kyoung-mo/pbv-cabin/supervisor/hmi/assets/modes/fullspace.png

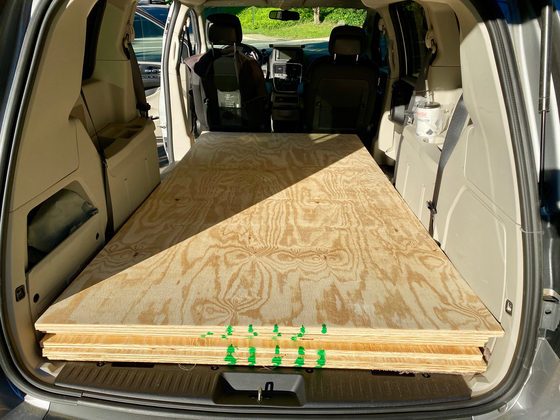
supervisor/hmi/assets/modes/fullspace.png
