kyoung-mo/pbv-cabin/supervisor/hmi/assets/modes/rest.png

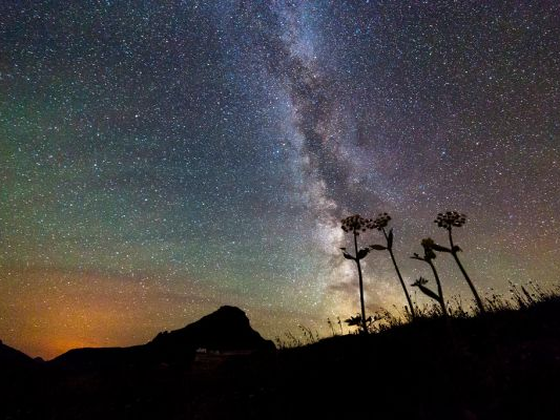
supervisor/hmi/assets/modes/rest.png
