kyoung-mo/pbv-cabin/assets/README.md

# assets — 프로젝트 정리 문서

프로젝트 서술형 산출물(정리본·요약 문서)을 두는 디렉토리.

## 내용
- **`project_summery_7.md`** — 가변 실내(Reconfigurable Cabin) **프로젝트 정리본 v7.0** (2026-07-03 기준).
  설계 원안(v6.0)을 저장소 코드와 1:1 대조해 갱신한 판으로, 각 절에 `📐 설계`(의도)와
  `🔧 구현`(코드 실측)을 병기하고, 설계-구현이 갈리는 지점을 As-Built 대조표로 모아 둔 문서.

## 주의 (문서 vs 코드)
- 이 정리본은 **2026-07-03 시점**이라, 이후 새로 구현된 것(Heartbeat 0x050 슈퍼바이저 송신,
  뒷좌석 호밍 시퀀스, 슬라이드 위치 피드백, 인터록의 슈퍼바이저 이관 등)은 반영돼 있지 않다.
- **최신·정확한 기준은 코드와 루트 [`README.md`](../README.md)** 다. 충돌 시 코드 실측을 따른다.

> 3D 모델·차체/좌석 이미지 등 HMI 런타임 에셋은 이 디렉토리가 아니라
> [`supervisor/hmi/assets/`](../supervisor/hmi/assets) 에 있다.
