kyoung-mo/pbv-cabin/supervisor/hmi/assets/car/car_00.png

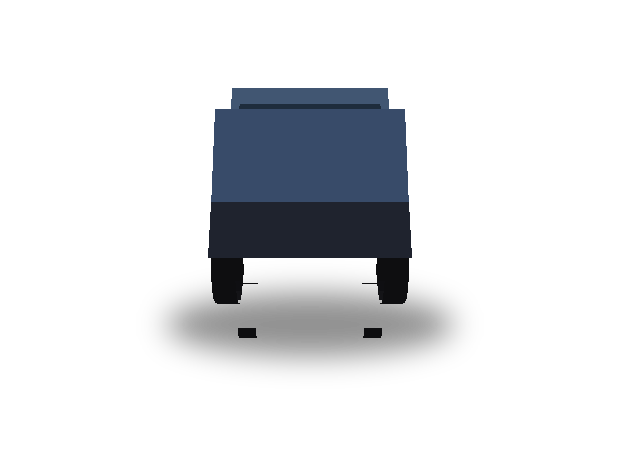
supervisor/hmi/assets/car/car_00.png
