kyoung-mo/pbv-cabin/supervisor/hmi/assets/car/car_03.png

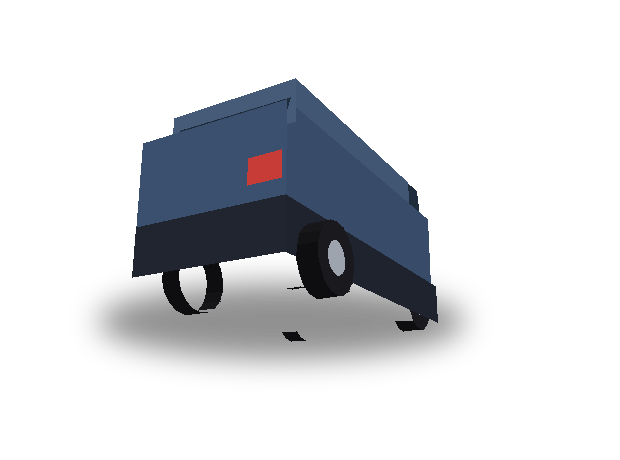
supervisor/hmi/assets/car/car_03.png
