kyoung-mo/pbv-cabin/supervisor/hmi/assets/car/car_04.png

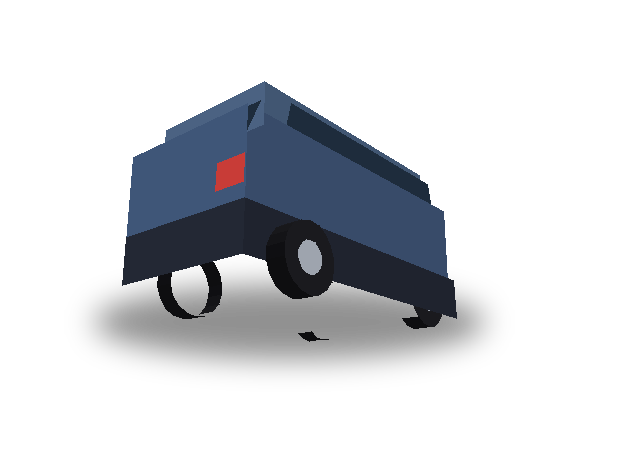
supervisor/hmi/assets/car/car_04.png
