kyoung-mo/pbv-cabin/supervisor/hmi/assets/car/car_05.png

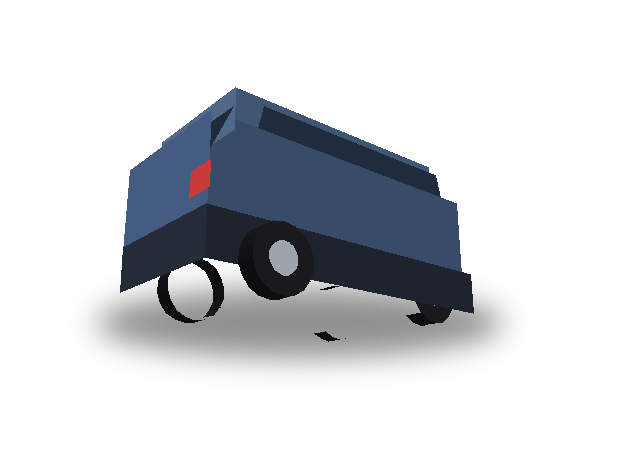
supervisor/hmi/assets/car/car_05.png
