kyoung-mo/pbv-cabin/supervisor/hmi/assets/car/car_07.png

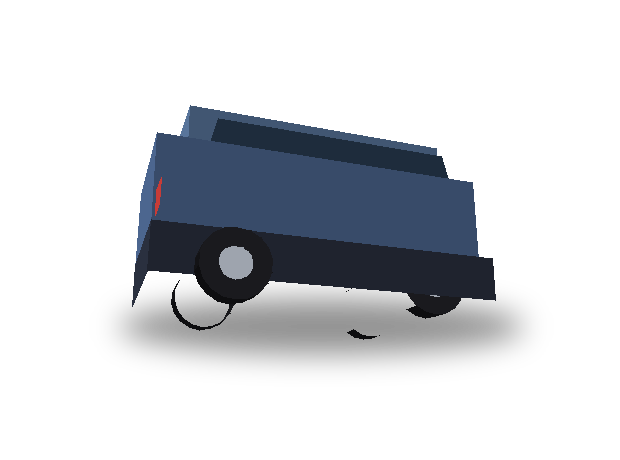
supervisor/hmi/assets/car/car_07.png
