kyoung-mo/pbv-cabin/supervisor/hmi/assets/car/car_08.png

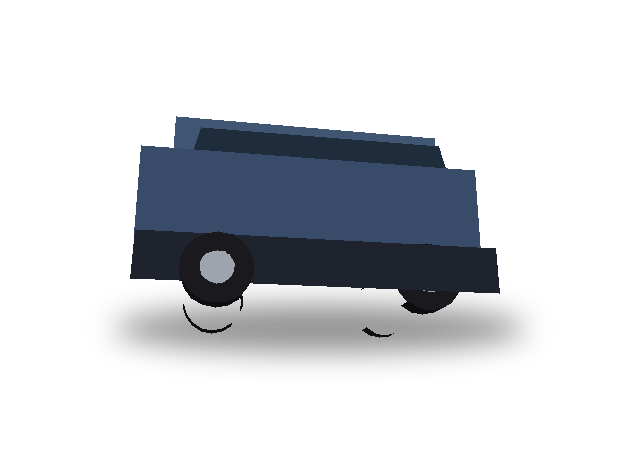
supervisor/hmi/assets/car/car_08.png
