kyoung-mo/pbv-cabin/supervisor/hmi/assets/car/car_09.png

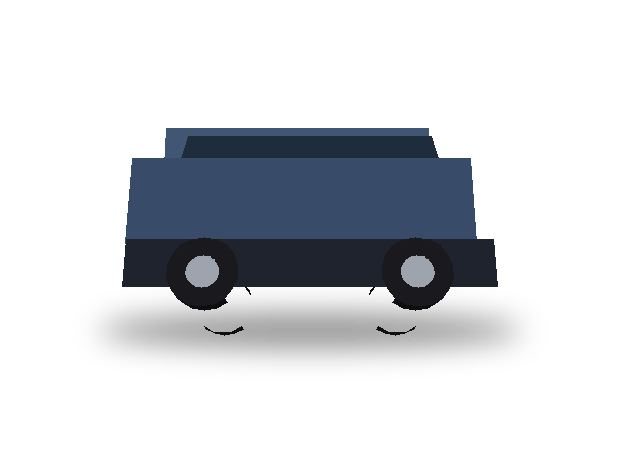
supervisor/hmi/assets/car/car_09.png
