kyoung-mo/pbv-cabin/supervisor/hmi/assets/car/car_12.png

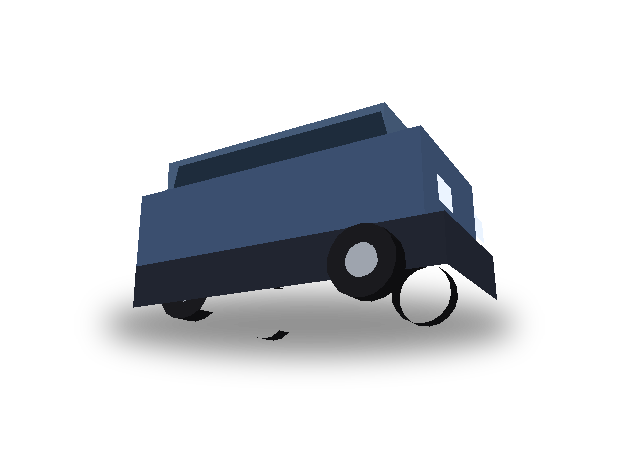
supervisor/hmi/assets/car/car_12.png
