kyoung-mo/pbv-cabin/supervisor/hmi/assets/car/car_14.png

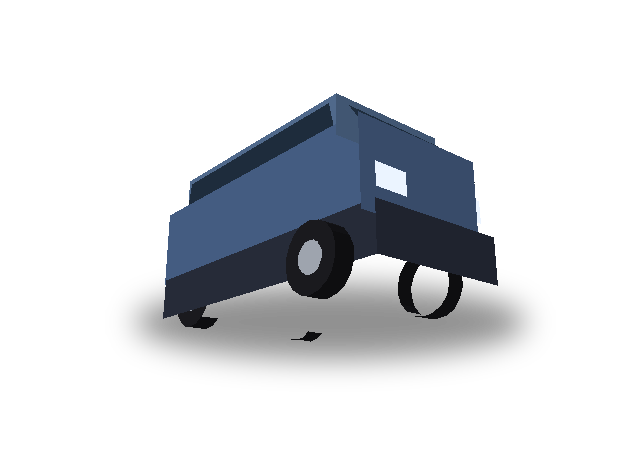
supervisor/hmi/assets/car/car_14.png
