kyoung-mo/pbv-cabin/supervisor/hmi/assets/car/car_15.png

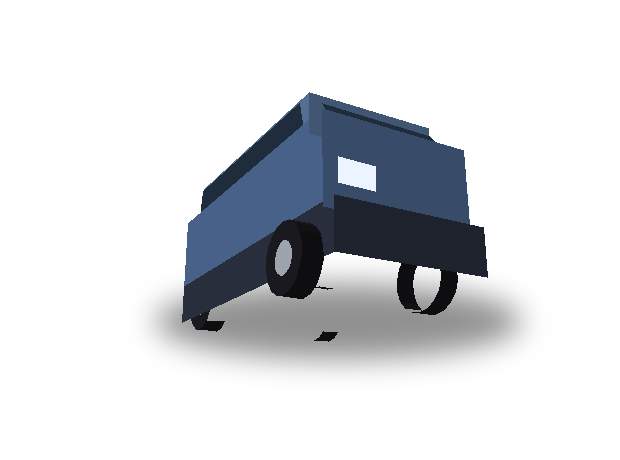
supervisor/hmi/assets/car/car_15.png
