kyoung-mo/pbv-cabin/supervisor/hmi/assets/car/car_16.png

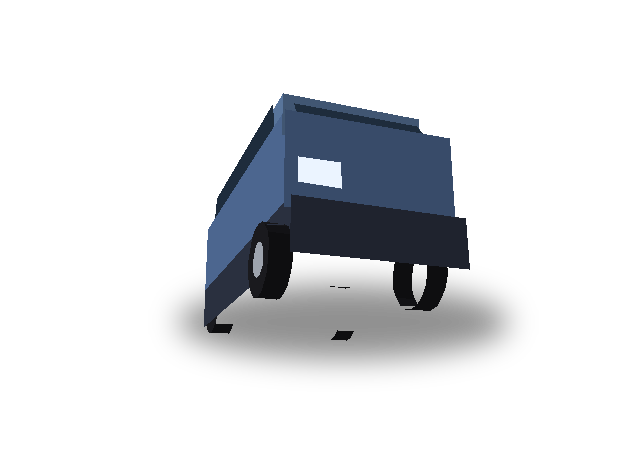
supervisor/hmi/assets/car/car_16.png
