kyoung-mo/pbv-cabin/supervisor/hmi/assets/car/car_26.png

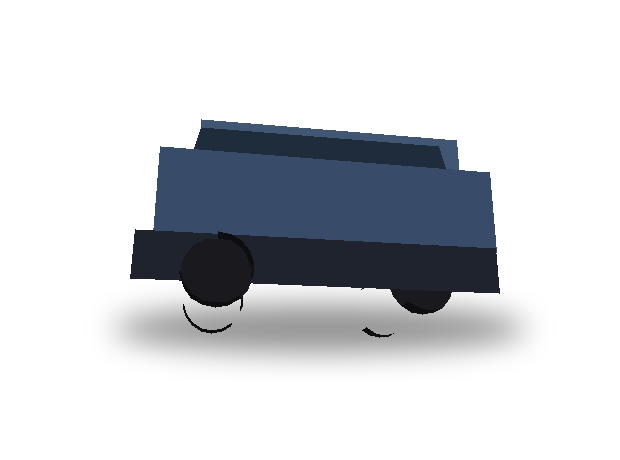
supervisor/hmi/assets/car/car_26.png
