kyoung-mo/pbv-cabin/supervisor/hmi/assets/car/car_27.png

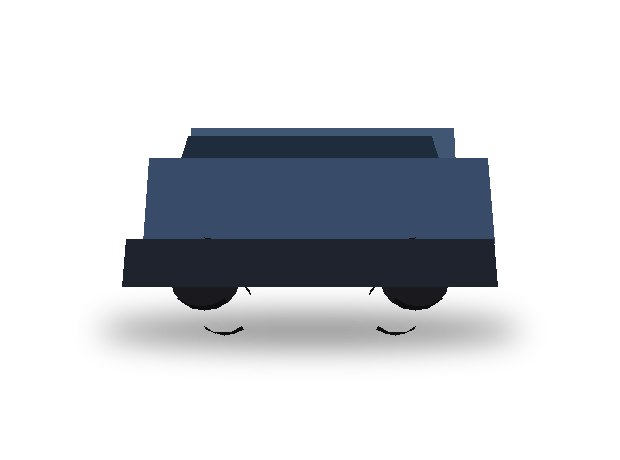
supervisor/hmi/assets/car/car_27.png
