kyoung-mo/pbv-cabin/supervisor/hmi/assets/car/car_29.png

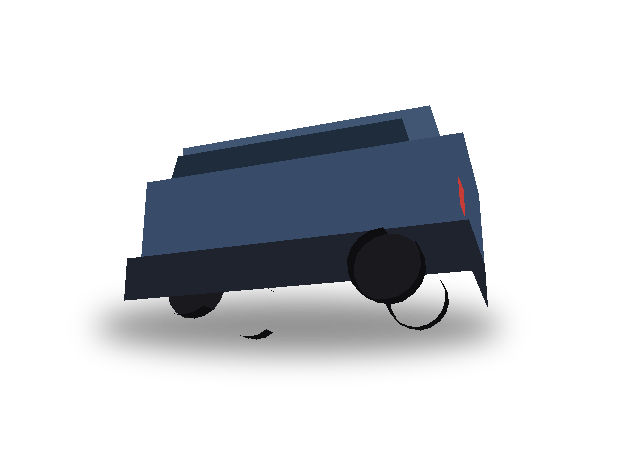
supervisor/hmi/assets/car/car_29.png
