kyoung-mo/pbv-cabin/supervisor/hmi/assets/car/car_30.png

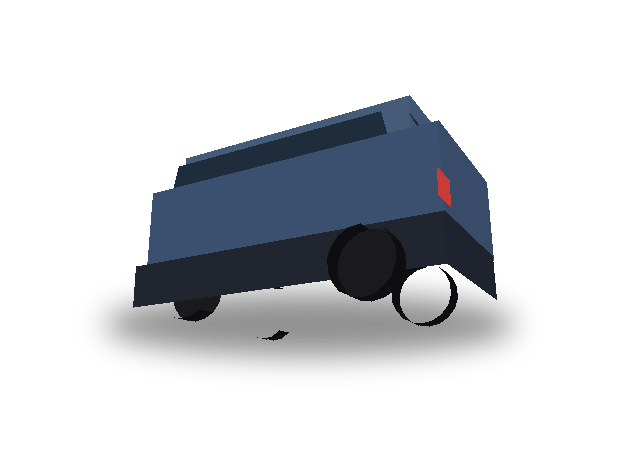
supervisor/hmi/assets/car/car_30.png
