kyoung-mo/pbv-cabin/supervisor/hmi/assets/car/car_32.png

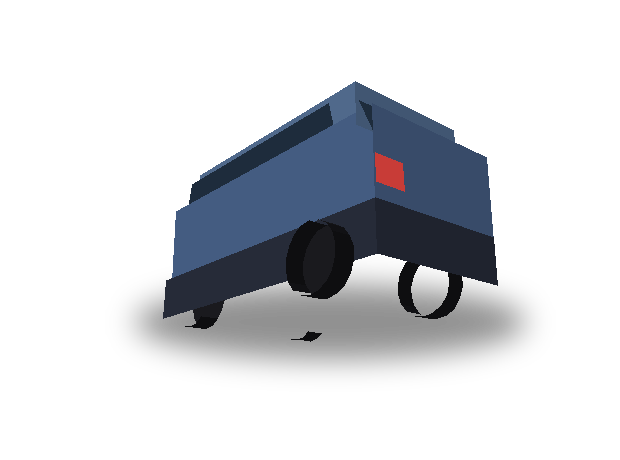
supervisor/hmi/assets/car/car_32.png
