kyoung-mo/pbv-cabin/supervisor/hmi/assets/modes/drive.png

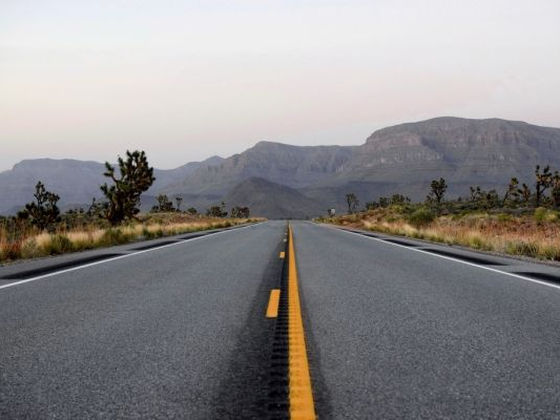
supervisor/hmi/assets/modes/drive.png
