kyoung-mo/pbv-cabin/supervisor/hmi/assets/modes/meeting.png

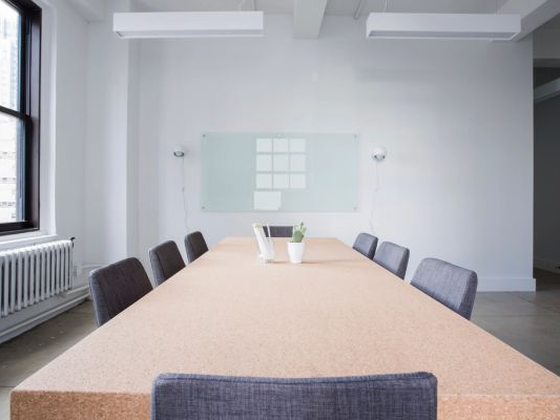
supervisor/hmi/assets/modes/meeting.png
