kyoung-mo/pbv-cabin/supervisor/hmi/assets/seats/overview.png

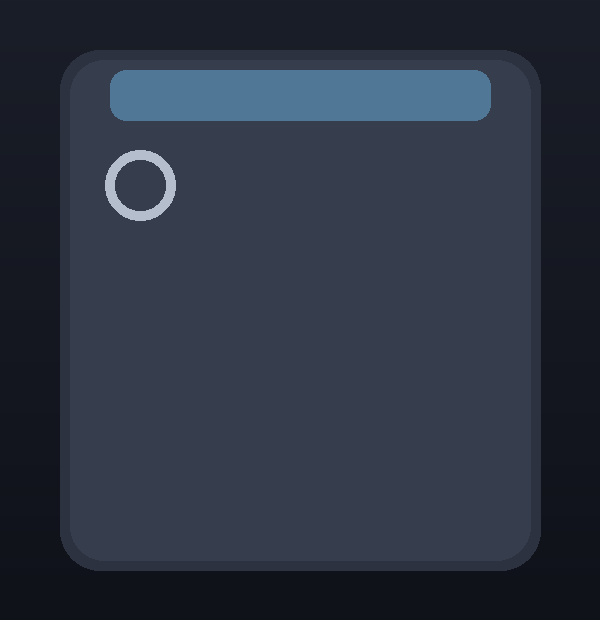
supervisor/hmi/assets/seats/overview.png
