kyoung-mo/pbv-cabin/supervisor/hmi/assets/seats/seat.png

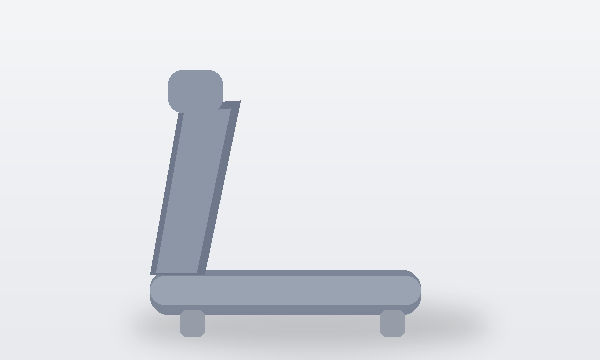
supervisor/hmi/assets/seats/seat.png
