kyoung-mo/pbv-cabin/ecu-drive/PowerTrain_F446/Core/Src/main.c

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
/* Includes ------------------------------------------------------------------*/
#include "main.h"

/* USER CODE BEGIN Includes */
#include "model_car_net.h"
/* USER CODE END Includes */

CAN_HandleTypeDef hcan1;

TIM_HandleTypeDef htim1;
TIM_HandleTypeDef htim2;
TIM_HandleTypeDef htim3;

UART_HandleTypeDef huart2;

/* USER CODE BEGIN PV */
/* CAN 통신용 구조체 변수 */
struct model_car_net_drive_cmd_t rx_drive_cmd;       // 수신된 주행 명령 저장용
struct model_car_net_drive_status_t tx_drive_status; // 송신할 구동 상태 저장용
struct model_car_net_heartbeat_t rx_heartbeat;       // 수신된 하트비트 저장용
struct model_car_net_gear_status_t rx_gear_status;   // 0x070 기어 상태 추가
struct model_car_net_safe_abort_t rx_safe_abort;     // 0x010 세이프 어보트 확장

/* CAN 송수신 하드웨어 핸들러 및 헤더 */
CAN_RxHeaderTypeDef rx_header;
CAN_TxHeaderTypeDef tx_header;
uint8_t rx_data[8];
uint8_t tx_data[8];
uint32_t tx_mailbox;

/* 하드웨어 테스트용 CAN 송신 변수 */
CAN_TxHeaderTypeDef test_tx_header;
uint8_t test_tx_data[8];
uint32_t test_mailbox;

/* 세이프티 및 페일세이프 관련 변수 */
volatile uint32_t cmd_watchdog_timer = 0; // 인터럽트 공유를 위해 전역으로 이동 및 volatile 적용
uint32_t supervisor_wd_timer = 0; // 하트비트 무응답 시간 누적용 (ms 단위 카운트)
uint8_t last_alive_counter = 0;   // 이전 하트비트 카운트 값 백업
bool is_emergency_active = false; // 현재 비상 정지 상태 여부 플래그
uint8_t current_gear = 0;         // 0=P, 1=D, 2=R 로컬 백업용

/* 엔코더 측정 및 속도 계산 변수 */
int16_t left_encoder_count = 0;
int16_t right_encoder_count = 0;
double current_rpm = 0.0;

/* 이전 듀티 저장용 전역 변수 */
uint32_t prev_left_duty = 0;
uint32_t prev_right_duty = 0;
/* USER CODE END PV */

void SystemClock_Config(void);
static void MX_GPIO_Init(void);
static void MX_USART2_UART_Init(void);
static void MX_CAN1_Init(void);
static void MX_TIM1_Init(void);
static void MX_TIM2_Init(void);
static void MX_TIM3_Init(void);
/* USER CODE BEGIN PFP */
double calculate_actual_rpm(int16_t left_counts, int16_t right_counts);
/* USER CODE END PFP */

/**
  * @brief  The application entry point.
  * @retval int
  */
int main(void)
{

  /* MCU Configuration--------------------------------------------------------*/

  /* Reset of all peripherals, Initializes the Flash interface and the Systick. */
  HAL_Init();

  /* Configure the system clock */
  SystemClock_Config();

  /* Initialize all configured peripherals */
  MX_GPIO_Init();
  MX_USART2_UART_Init();
  MX_CAN1_Init();
  MX_TIM1_Init();
  MX_TIM2_Init();
  MX_TIM3_Init();
  /* USER CODE BEGIN 2 */
  /* ====================================================================
 * 1. CAN 하드웨어 활성화 및 필터 마스터 세팅 (PCAN-View 통신 개통용)
 * ==================================================================== */


// 모든 CAN ID를 필터링 없이 다 받아들이는 '마스터 오픈 필터' 설정
CAN_FilterTypeDef canFilter;
canFilter.FilterBank = 0;
canFilter.FilterMode = CAN_FILTERMODE_IDMASK;
canFilter.FilterScale = CAN_FILTERSCALE_32BIT;
canFilter.FilterIdHigh = 0x0000;
canFilter.FilterIdLow = 0x0000;
canFilter.FilterMaskIdHigh = 0x0000;
canFilter.FilterMaskIdLow = 0x0000;
canFilter.FilterFIFOAssignment = CAN_RX_FIFO0;
canFilter.FilterActivation = ENABLE;
canFilter.SlaveStartFilterBank = 14;

if (HAL_CAN_ConfigFilter(&hcan1, &canFilter) != HAL_OK) {
	Error_Handler(); // 필터 설정 실패 시 잠금
}

// CAN 외장 하드웨어 선로 전격 개통! (이게 켜져야 PCAN Receive가 뚫립니다)
if (HAL_CAN_Start(&hcan1) != HAL_OK) {
	Error_Handler();
}

// CAN 수신 인터럽트(FIFO0 Pending) 활성화
if (HAL_CAN_ActivateNotification(&hcan1, CAN_IT_RX_FIFO0_MSG_PENDING) != HAL_OK) {
	Error_Handler();
}

// 송신 헤더 설정
//tx_header.StdId = 0x102; // F446용 테스트 ID
//tx_header.RTR = CAN_RTR_DATA;
//tx_header.IDE = CAN_ID_STD;
//tx_header.DLC = 8;
//tx_header.TransmitGlobalTime = DISABLE;

/* ====================================================================
 * 2. 타이머 하드웨어 기동 (좌/우 모터 및 엔코더 작동 시작)
 * ==================================================================== */
// (1) TIM1 PWM 출력 채널 가동 (모터 속도 제어선 활성화)
HAL_TIM_PWM_Start(&htim1, TIM_CHANNEL_1); // PA8 (PWMA)
HAL_TIM_PWM_Start(&htim1, TIM_CHANNEL_2); // PA9 (PWMB)

// (2) TIM2, TIM3 엔코더 카운터 하드웨어 감시 기동
HAL_TIM_Encoder_Start(&htim2, TIM_CHANNEL_ALL); // 왼쪽 바퀴 엔코더 감시 시작
HAL_TIM_Encoder_Start(&htim3, TIM_CHANNEL_ALL); // 오른쪽 바퀴 엔코더 감시 시작
  /* USER CODE END 2 */

  /* Infinite loop */
  /* USER CODE BEGIN WHILE */
  while (1)
  {
    /* USER CODE END WHILE */

    /* USER CODE BEGIN 3 */
	HAL_Delay(10);
	if (cmd_watchdog_timer < 1000) {
		cmd_watchdog_timer += 10;
	}

	// 2. [엔코더 데이터 수집] 좌/우 타이머 카운터 레지스터에서 펄스 값 실시간 획득
	left_encoder_count  = (int16_t)__HAL_TIM_GET_COUNTER(&htim2);
	right_encoder_count = (int16_t)__HAL_TIM_GET_COUNTER(&htim3);
	__HAL_TIM_SET_COUNTER(&htim2, 0);
	__HAL_TIM_SET_COUNTER(&htim3, 0);

	// 실시간 실제 RPM 산출
	current_rpm = calculate_actual_rpm(left_encoder_count, right_encoder_count);

	// [최우선순위 안전 제어] 비상정지 락이 걸렸거나, 300ms 동안 주행명령(0x100)이 끊겼다면 (Timeout)?
	if (is_emergency_active || cmd_watchdog_timer > 300)
	{
		// 모터 즉각 정지 및 Short Brake 잠금 발동
		HAL_GPIO_WritePin(GPIOB, GPIO_PIN_5, GPIO_PIN_SET);   // IN1
		HAL_GPIO_WritePin(GPIOB, GPIO_PIN_4, GPIO_PIN_SET);   // IN2
		HAL_GPIO_WritePin(GPIOB, GPIO_PIN_10, GPIO_PIN_SET);  // IN3
		HAL_GPIO_WritePin(GPIOA, GPIO_PIN_10, GPIO_PIN_SET);  // IN4
		__HAL_TIM_SET_COMPARE(&htim1, TIM_CHANNEL_1, 0);
		__HAL_TIM_SET_COMPARE(&htim1, TIM_CHANNEL_2, 0);

		// ★ [Fail-Safe 가드 레일 보완] 비상 정지 복귀 시 Ramp 튐 현상을 막기 위해 백업 데이터 리셋
		prev_left_duty = 0;
		prev_right_duty = 0;

		// 피드백 데이터 빌드: 속도는 0, 현재 기어 상태 및 에러 플래그 결합 송신
		tx_drive_status.current_velocity = 0;
		tx_drive_status.current_gear_status = current_gear;
		tx_drive_status.drive_motor_current = 0;

		// 0x102 Drive_Status CAN 송신 함수 호출 (10ms 주기 세이프티 송신)
		model_car_net_drive_status_pack(tx_data, &tx_drive_status, sizeof(tx_data));

		tx_header.StdId = MODEL_CAR_NET_DRIVE_STATUS_FRAME_ID; // 0x200
		tx_header.RTR = CAN_RTR_DATA;
		tx_header.IDE = CAN_ID_STD;
		tx_header.DLC = MODEL_CAR_NET_DRIVE_STATUS_LENGTH;     // 8u
		HAL_CAN_AddTxMessage(&hcan1, &tx_header, tx_data, &tx_mailbox);

		continue; // 아래 주행 로직을 스킵하고 루프 처음으로 점프
	}

	// 4. [일반 주행 제어] 기어 상태 인터록 및 상하위 속도 연산
	double brake_factor = (100.0 - (double)rx_drive_cmd.brake_depth) / 100.0;
	double v_base = (double)rx_drive_cmd.target_velocity * brake_factor;

	double K = 0.5; // 필요시 민감도를 2.5 등으로 올려서 테스트하세요!
	double v_steer = (double)rx_drive_cmd.steering_angle * K;

	double target_left_rpm  = v_base + v_steer;
	double target_right_rpm = v_base - v_steer;

	if (rx_drive_cmd.brake_depth >= 100) {
		target_left_rpm = 0; target_right_rpm = 0;
	}

	if (target_left_rpm < 0)  target_left_rpm = 0;
	if (target_right_rpm < 0) target_right_rpm = 0;

	uint32_t left_duty  = ((uint32_t)target_left_rpm * 999) / 3000;
	uint32_t right_duty = ((uint32_t)target_right_rpm * 999) / 3000;

	if (left_duty > 999)  left_duty = 999;
	if (right_duty > 999) right_duty = 999;

	#define MAX_DUTY_STEP 15
	// 왼쪽 바퀴 Ramp 적용
	if (left_duty > prev_left_duty) {
		if ((left_duty - prev_left_duty) > MAX_DUTY_STEP) left_duty = prev_left_duty + MAX_DUTY_STEP;
	} else if (left_duty < prev_left_duty) {
		if ((prev_left_duty - left_duty) > MAX_DUTY_STEP) left_duty = prev_left_duty - MAX_DUTY_STEP;
	}

	// 오른쪽 바퀴 Ramp 적용
	if (right_duty > prev_right_duty) {
		if ((right_duty - prev_right_duty) > MAX_DUTY_STEP) right_duty = prev_right_duty + MAX_DUTY_STEP;
	} else if (right_duty < prev_right_duty) {
		if ((prev_right_duty - right_duty) > MAX_DUTY_STEP) right_duty = prev_right_duty - MAX_DUTY_STEP;
	}

	// 다음 루프를 위해 현재 값 백업
	prev_left_duty = left_duty;
	prev_right_duty = right_duty;

	// [일반 주행 제어] 기어 상태 인터록 검증
	if (current_gear == 1) // 1 = Drive(D)
	{
		HAL_GPIO_WritePin(GPIOB, GPIO_PIN_5, GPIO_PIN_SET);   // AIN1 = HIGH
		HAL_GPIO_WritePin(GPIOB, GPIO_PIN_4, GPIO_PIN_RESET); // AIN2 = LOW
		HAL_GPIO_WritePin(GPIOB, GPIO_PIN_10, GPIO_PIN_SET);  // BIN1 = HIGH
		HAL_GPIO_WritePin(GPIOA, GPIO_PIN_10, GPIO_PIN_RESET); // BIN2 = LOW

		__HAL_TIM_SET_COMPARE(&htim1, TIM_CHANNEL_1, left_duty);
		__HAL_TIM_SET_COMPARE(&htim1, TIM_CHANNEL_2, right_duty);
	}
	else if (current_gear == 2) // 2 = Reverse
	{
		HAL_GPIO_WritePin(GPIOB, GPIO_PIN_5, GPIO_PIN_RESET);   // AIN1 = LOW
		HAL_GPIO_WritePin(GPIOB, GPIO_PIN_4, GPIO_PIN_SET);     // AIN2 = HIGH
		HAL_GPIO_WritePin(GPIOB, GPIO_PIN_10, GPIO_PIN_RESET);  // BIN1 = LOW
		HAL_GPIO_WritePin(GPIOA, GPIO_PIN_10, GPIO_PIN_SET);    // BIN2 = HIGH

		__HAL_TIM_SET_COMPARE(&htim1, TIM_CHANNEL_1, left_duty);
		__HAL_TIM_SET_COMPARE(&htim1, TIM_CHANNEL_2, right_duty);
	}
	else // P(0) 모드이거나 예외 상태 시 안전 정지
	{
		HAL_GPIO_WritePin(GPIOB, GPIO_PIN_5, GPIO_PIN_SET);
		HAL_GPIO_WritePin(GPIOB, GPIO_PIN_4, GPIO_PIN_SET);
		HAL_GPIO_WritePin(GPIOB, GPIO_PIN_10, GPIO_PIN_SET);
		HAL_GPIO_WritePin(GPIOA, GPIO_PIN_10, GPIO_PIN_SET);

		__HAL_TIM_SET_COMPARE(&htim1, TIM_CHANNEL_1, 0);
		__HAL_TIM_SET_COMPARE(&htim1, TIM_CHANNEL_2, 0);
	}
	// 5. [상태 피드백 역송신] 0x102 Drive_Status 주기 송신 처리
	// 인코드 함수 규격에 맞춰 정수형 변환 처리 (ex: 0.1 스케일 팩터가 있다면 10배 곱해짐)
	tx_drive_status.current_velocity = (int16_t)(current_rpm);
	tx_drive_status.current_gear_status = current_gear;

	// 라이브러리 패킹 후 CAN Mailbox로 데이터 밀어내기
	model_car_net_drive_status_pack(tx_data, &tx_drive_status, sizeof(tx_data));

	tx_header.StdId = MODEL_CAR_NET_DRIVE_STATUS_FRAME_ID; // 0x200
	tx_header.RTR = CAN_RTR_DATA;
	tx_header.IDE = CAN_ID_STD;
	tx_header.DLC = MODEL_CAR_NET_DRIVE_STATUS_LENGTH;     // 8u
	HAL_CAN_AddTxMessage(&hcan1, &tx_header, tx_data, &tx_mailbox);
  }
  /* USER CODE END 3 */
}

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
/* USER CODE BEGIN 4 */
double calculate_actual_rpm(int16_t left_counts, int16_t right_counts)
{
    // 두 바퀴의 평균 펄스 변화량
    double avg_counts = (double)(left_counts + right_counts) / 2.0;

    /* [RPM 계산 가이드라인]
     * JBG37-520 모터의 감속비가 예를 들어 1:30이고 홀센서가 한 바퀴에 11펄스를 뿜는다면,
     * 4체배 시 바퀴 1회전당 총 펄스(PPR) = 11 * 4 * 30 = 1320 펄스입니다.
     * 10ms(0.01초) 주기로 셈하므로: RPM = (avg_counts / 1320) * (60초 / 0.01초)
     */
    double ppr = 1320.0; // 팀의 모터 상세 스펙에 맞춰 수정 가능
    double actual_rpm = (avg_counts / ppr) * 6000.0;

    return actual_rpm;
}

void HAL_CAN_RxFifo0MsgPendingCallback(CAN_HandleTypeDef *hcan)
{

	if (HAL_CAN_GetRxMessage(hcan, CAN_RX_FIFO0, &rx_header, rx_data) != HAL_OK) return;

	HAL_GPIO_TogglePin(LD2_GPIO_Port, LD2_Pin); // 정상 수신 알림 점멸

	// 1. 비상 정지 수신
	if (rx_header.StdId == MODEL_CAR_NET_SAFE_ABORT_FRAME_ID) {
		model_car_net_safe_abort_unpack(&rx_safe_abort, rx_data, rx_header.DLC);
		if (rx_safe_abort.stop_flag == 1) {
			is_emergency_active = true;
		} else if (rx_safe_abort.stop_flag == 0) {
			// (3)번 문제 해결: stop_flag가 명시적으로 0이 들어오면 비상 정지 해제!
			is_emergency_active = false;
		}
	}
	// 2. 기어 상태 수신
	else if (rx_header.StdId == MODEL_CAR_NET_GEAR_STATUS_FRAME_ID) {
		model_car_net_gear_status_unpack(&rx_gear_status, rx_data, rx_header.DLC);
		current_gear = rx_gear_status.gear;
	}
	// 3. 주행 명령 수신
	else if (rx_header.StdId == MODEL_CAR_NET_DRIVE_CMD_FRAME_ID) {
		model_car_net_drive_cmd_unpack(&rx_drive_cmd, rx_data, rx_header.DLC);
		cmd_watchdog_timer = 0; // (1),(2)번 문제 해결을 위한 통신 와치독 타이머 리셋!
	}
}
/* USER CODE END 4 */
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
