kyoung-mo/pbv-cabin/(commit log)

2026-06-22 can 메시지별 신호 잡기
2026-06-22 can dbc 수정, main.c skeleton complete
2026-06-23 modified ioc, motor control logic added to main.c
2026-06-23 fix main.c for modified DBC
    [PowerTrain_F446.ioc, main.c]
2026-06-25 can 통신을 통한 모터 제어 성공. 예외처리 및 상세화 필요
2026-06-29 기능 테스트 완료. 회로 안전 로직 필요
2026-06-30 로직 수정한 버전. 실물 테스트 아직 못함
    [main.c]
2026-06-30 ecu-rear-cargo: 펌웨어 slide3(TMC2208 2축) 추가, 기존본 slide2로 이동
    - firmware/slide3: TMC2208 STEP/DIR/EN 2축(RL/RR) + SG90 서보 x2 + INA226 안티핀치 + model_car_net(DBC). DWT us 타이밍, 가속램프, 1/2 마이크로스텝.
    - firmware/slide2: 기존 스켈레톤 보존용 이동.
2026-06-30 supervisor/hmi: CAN 양방향 연동 + 휠 입력 통합 + 체크섬 ECU 정합(8bit 합)
2026-07-01 freeRTOS 버전 추가 / 테스트 X
2026-07-01 add can message && racing wheel(?) data
2026-07-01 기능 정상 동작 확인 조향각에 따른 앞바퀴 회전은 미반영
2026-07-01 조향각에 따른 바퀴 회전 추가
2026-07-01 D/R 모드에 따라 엑셀 -> 바퀴 회전 추가
2026-07-01 조향각에 따른 시각적 표시 추가
2026-07-01 조향 핸들 색상 변경
2026-07-02 HDMI 작동 테스트 완료
2026-07-02 HMI 화면 수정. 기어 P인 상태에서도 조향각, 엑셀, 브레이크 읽을 수 있도록
    [vehicle_state.py, wheel_input.py]
2026-07-02 ecu-rear-cargo: slide4 FreeRTOS 포팅 추가 (MotionTask/StatusTask, RL/RR 2축 동작)
2026-07-02 UI 개선(하단바 크기 조절 + 홈 모드에서 자동차 보이는 모습)
2026-07-03 좌석 과전류 긴급정지(E-stop) 상태 표시 추가
    3D 좌석에 과전류 긴급정지 시 빨강~핑크 깜빡임 경고. vehicle_state에
    seatEstop 프로퍼티/estopChanged 시그널/setSeatEstop 슬롯 추가(CAN 수신 훅).
2026-07-03 docs: 프로젝트 정리본 v7.0 추가 + 낡은 interface DBC 삭제
    assets/project_summery_7.md 신규(코드 실측 대조본). CAN 정본을
    supervisor/dbc로 확정하고, 초기 업로드본 interface/dbc/model_car_net.dbc 제거.
2026-07-05 rear-cargo: 슬라이드 2축 인터록 추가 (동시구동 차단)
    - slide_service에 s_active 인터록: 한 번에 한 축만 스텝(RL 우선),
    대기축 드라이버 OFF → 동시 구동의 과전류·회생 스파이크로 인한
    드라이버 손상 방지
    - slide_is_moving / slide_ch_is_moving / slide_ch_pending API 추가
    - 런타임/부팅 호밍 모두 단일축 보장
    - model_car_net.dbc 포함
2026-07-05 rear-slide: 원점 정렬(호밍) 확인-스텝 시퀀스 + 부팅 자동 호밍
    - vehicle_state: 뒷좌석 슬라이드 호밍 시퀀스(왼쪽→확인→오른쪽→확인→주행자세
    복귀), 직렬화 인터록(두 리니어 동시 구동 금지), homingActive/Prompt Property.
    - can_hub: send_seat_cmd slide_raw 인자 추가 — 254(HOME)/255(REZERO) 센티넬을
    DBC 무변경으로 byte1 직접 덮어써 송신.
    - main: 부팅 1.2s 뒤 자동 원점 정렬 시작(slide4 SLIDE_HOMING=0 보완).
    - Main.qml/SeatOverview.qml: 호밍 오버레이(화면 잠금+확인 버튼) + 수동 원점
    버튼, 끼임 배지.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
2026-07-05 rear-cargo: 슬라이드 현재위치 CAN 상태 피드백 추가 (0x220/0x221 byte2)
    - DBC/생성코드: Rear_*_Seat_Status DLC 2→3, Curr_RL/RR_Slide(0~100mm) 추가
    (팀 재생성본 채용, cantools 41.4.3)
    - slide.c/h: homed 플래그 + slide_report_pos_mm()
    · 원점 미확정(부팅/호밍 중)엔 0xFF 센티넬 → 중앙이 "호밍 필요"로 인식
    · 254 호밍 완료 / 255 재영점에서 homed=1 → 실제 0~100 보고
    - main.c send_status: byte2 = slide_report_pos_mm(ch)
    - main.c: 비상 핸들러를 SafeAbort로 정정(옛 HMI_Emergency 참조가
    stale 생성코드에 의존하던 잠재 불일치 → 재생성으로 표면화된 것 수정)
    - STM32CubeCLT 빌드 통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
    [main.c]
2026-07-05 supervisor: 끼임(과전류) 감지 오버레이 + 확인 시 재명령 래치 해제
    - vehicle_state: pinchPrompt(안내문) / resolvePinch(끼인 좌석 재명령→펌웨어 래치 해제)
    - Main.qml: 오른쪽 패널 위 경고 오버레이 + [확인] 버튼
    ※ 실물 검증은 뒷자리 펌웨어 완성본과 통합 후 확인 예정.
    [vehicle_state.py]
2026-07-05 supervisor/dbc: 뒷좌석 슬라이드 위치 피드백 반영 (firmware 완성본 동기화)
    Rear_Left/Right_Seat_Status DLC 2->3, byte2에 Curr_RL/RR_Slide(16|8, [0|100]mm) 추가.
    ecu-rear-cargo 정본 DBC와 동일 정의. HMI 디코드 규약: slide==255 원점미확정 / 0~100 실측mm.
2026-07-05 supervisor: 뒷좌석 슬라이드 위치 피드백 수신(closed-loop 스냅)
    리어 ECU가 Rear_Left/Right_Seat_Status byte2(Curr_*_Slide)로 슬라이드 위치를 보고
    (0~100mm, 255=원점 미확정). 이동 중엔 StatusTask 기아로 상태가 끊기고 완료 시 재개되며
    그 프레임에 도착 위치가 실린다.
    - can_hub: SEAT_STATUS_DEF에 slide 시그널 추가, seatStatusReceived에 slide 인자(앞좌석 -1).
    - vehicle_state.onSeatStatus: 255=원점 미확정(homed 해제) / 0~100=실측 → axis2.current 스냅
    (_apply_rear_slide_feedback). current만 스냅해 사용자 target 유지(과부하로 덜 가면 dirty로 표시).
    진행 중 open-loop 트윈은 실측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
2026-07-05 rear-cargo: 인터록 제거(supervisor가 직렬화) + 이동 중 위치 송신
2026-07-06 ecu-front: ecu-front 브랜치 최신 펌웨어 반영 (front_seat_app 구조화 + pinchdetect 안티핀치 추가)
2026-07-06 supervisor: 뒷좌석 좌/우 스왑 + 앞좌석 초기화(90°/0°) + 주행 D/R 방향 보정
    - 뒷좌석 좌/우 물리 반전을 CAN 매핑(SEAT_CMD_DEF/SEAT_STATUS_DEF)에서 보정(명령·피드백 동시 스왑, Cargo_Lamp는 신호 존재로 판별)
    - 앞좌석 초기 자세(리클라인 90°/회전 0°)를 부팅 시 supervisor가 0x110/0x111로 능동 송신(initFrontSeats)
    - Drive_ECU 방향 반전 보정: GEAR_CAN_VALUE D/R 스왑(D=2/R=1) → D=전진, R=후진
2026-07-06 cluster: cluster 브랜치의 cluster/ 디렉토리 병합 (supervision.py 추가)
2026-07-07 supervisor: Central_Supervisor Heartbeat(0x050) 상시 송신 추가
    can_hub 에 전용 데몬 스레드로 Heartbeat(Alive_Counter 0~255 순환)를 100ms
    주기로 송신한다. 감시 노드(Monitor_Node)는 이 하트비트가 몇 초 끊기면 메인
    제어기가 죽었다고 보고 SafeAbort(0x010)를 발신하는데, 기존엔 실제 supervisor
    가 하트비트를 전혀 안 보내고 cluster/supervision.py(검증용 시뮬레이터)만
    보내고 있었다.
    - GUI/QML 이벤트 루프와 독립된 전용 스레드에서 송신(렌더 지터 무관)
    - 루프 내 blocking I/O(print) 없음
    - 절대시각 스케줄로 드리프트/누적 지연 제거
    - 기존 _send(Lock 직렬화 + 실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
2026-07-07 supervisor: 뒷좌석 원점 정렬(호밍) 시퀀스 복원 + 신뢰성 강화
    - main.py: 부팅 자동 뒷좌석 호밍(homeRearSlides) 재활성화
    - 호밍 254: 확인 전까지 100ms 주기 연속 송신(_home_timer) — 프레임 드롭 시 다음 틱이 만회
    - 재영점 255: 그 좌석이 원점확정(slide 0~250) 보고할 때까지 재전송(ack) 후 다음 단계
    → 255 씹혀 homeRemaining>0 로 계속 호밍(원점쪽)하던 문제 방지
    - 슬라이드 완료판정: '상태 끊김→재개'(slide4는 이동중에도 송신)에서 '보고 위치=target 도달'
    위치기반으로 전환 → 두 리니어 동시 구동(과전류) 방지, 진짜 순차 보장
    - 이동 명령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
2026-07-08 최종 시연 전 코드
2026-07-08 front-ecu FreeRTOS 추가 및 File 정리
2026-07-21 Modify anti-pinch threshold in README
    Updated anti-pinch threshold from 170mA to 460mA in the README.
