kyoung-mo/pbv-cabin/(notices)

Notices in the files:
ecu-rear-cargo/fw_slide4/Core/Src/main.c:
Copyright (c) 2026 STMicroelectronics.
All rights reserved.
This software is licensed under terms that can be found in the LICENSE file
